tronicgr/AMC-AASD15A-Firmware/Syntron_HS_interface/README.md

Interface to Syntron HS servo

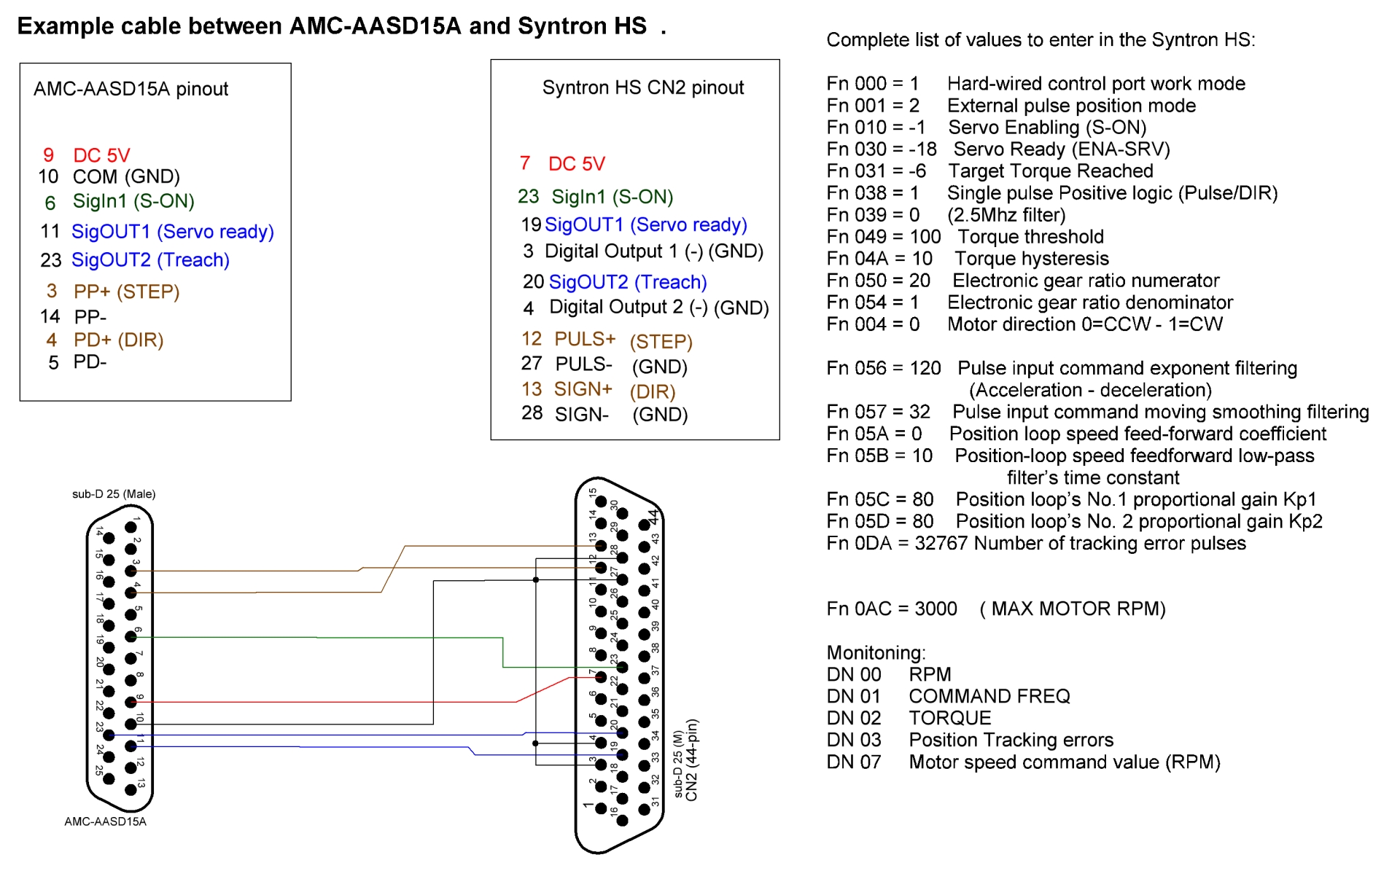
[picture p21: Syntron_HS_interface/AMC-AASD15A - Syntron HS connections schematic_sm.jpg]
