tronicgr/AMC-AASD15A-Firmware/Latest_firmware/MEGA2560_chip/README.md

Firmware files for AtMega2560 chip (256k).

-Firmware file link. (download the zip file and unpack it before using).

-AVRUBD utility to update the firmware, with settings for 2560 chip.

### Firmware Update procedure video
https://www.youtube.com/watch?v=F8kSDIicgcA

### INPORTANT notice:
- After loading new firmware, please hold down the "EXIT" button on the panel and press and release the "RESET" button on the controller to restore default parameters. See how its done on this video: https://www.youtube.com/watch?v=g12Grq-1LBQ

# Please use the AVRUBD utility in this folder to update the firmware on the controller.

-- enc_2560_SH_AMC_AASD15A_v2_26_fix9-3_RGB (2560 chipset only) (7/15/2025)
--------------------------------------------------
- Fixed platform naming, had some typos.
- Added backtrack for the defined vertical actuators, to correctly reposition when using the Simhub power saving option.
- Fixed calibration of horizontal actuators to be non blocking. Now repositions to 50% in the background.
- Belt tensioner can also power off with Simhub power saving option, as long is defined as vertical actuator type.
- FIXED LCD Menu rollover overflow
- 
-- ADDED platform presets:
- 1. RS-COMPETITION eracinglab platform 2xTL/Surge
- 2. eracinglab platform Belt/TL/SURGE
- 3. HEXAPOD - ROTARY (50:1, 140degrees)
- ADDED Parameters export dump, and quick manual F-Stop test sequence.

- Download shortcut: 
[enc_2560_SH_AMC_AASD15A_v2_26_fix9-3_RGB.zip](https://github.com/tronicgr/AMC-AASD15A-Firmware/blob/master/Latest_firmware/MEGA2560_chip/enc_2560_SH_AMC_AASD15A_v2_26_fix9-3_RGB.zip)
