tronicgr/AMC-AASD15A-Firmware/Thanos-utility/AMC-AASD_Config_tool/README.md

This is a remote configuration tool for the AMC-AASD15A controller boards.

It requires the firmware version v2.26 fix0 to function correctly. If you have older firmware it may not retrieve or save correctly all parameters.
