tronicgr/AMC-AASD15A-Firmware/Simtools_interface_plugin/README.md

Download and use this interface plugin for simtools
https://github.com/tronicgr/AMC-AASD15A-Firmware/blob/master/Simtools_interface_plugin/AMC_InterfacePlugin.zip

From the dropdown menu select "AASD15A"

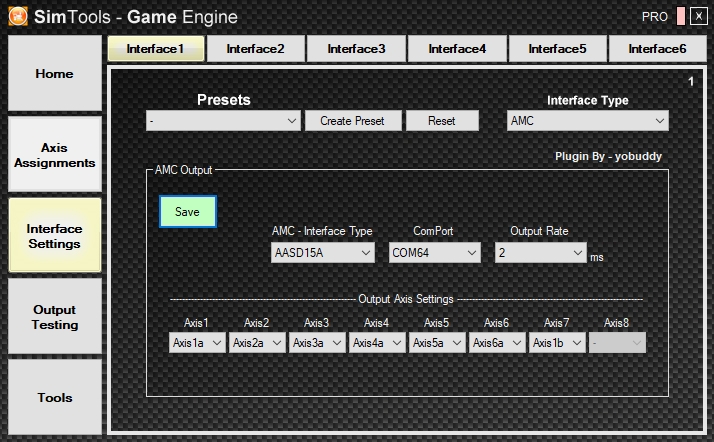
[picture p22: Simtools_interface_plugin/AMC_interface_plugin_AASD15A.jpg]


### You can use the AMC config tool v1.2 to access and modify the parameters in the AMC-AASD15A (Firmware v2.11 fix5):
https://github.com/tronicgr/AMC-AASD15A-Firmware/blob/master/Simtools_interface_plugin/AMC_Config_tool_1_2.zip

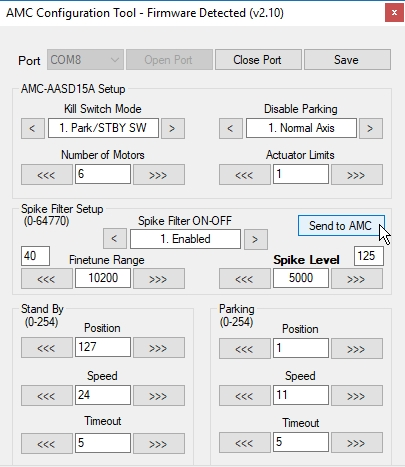
[picture p23: Simtools_interface_plugin/AMC-Config-tool-v1_2_AASD.jpg]
