tronicgr/AMC-AASD15A-Firmware/DornaM1_interface/AMC-AASD15A to Dorna EPS-B1 servomotor connections schematic.jpg

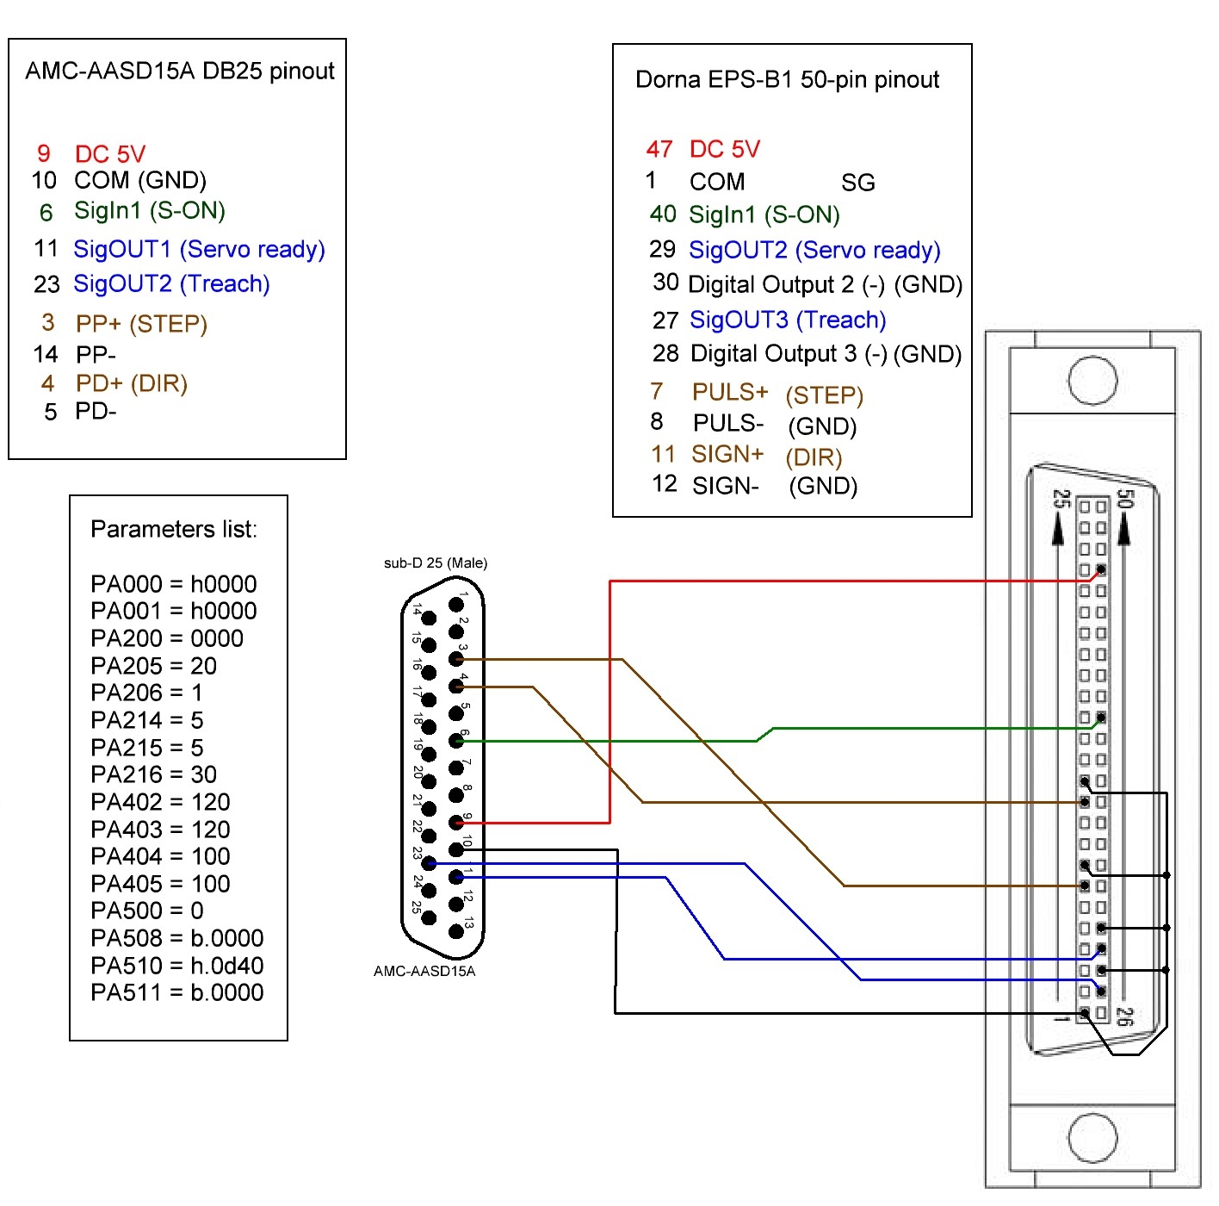
DornaM1_interface/AMC-AASD15A to Dorna EPS-B1 servomotor connections schematic.jpg
