tronicgr/AMC-AASD15A-Firmware/IMG_20190518_080840.jpg

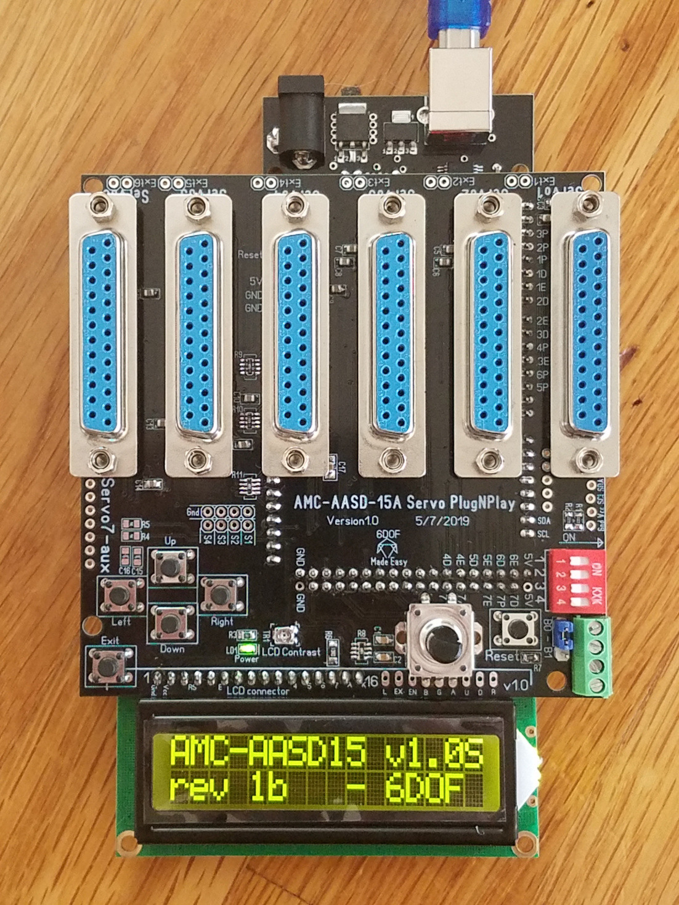
IMG_20190518_080840.jpg
