tronicgr/AMC-AASD15A-Firmware/Latest_firmware/1280_firm_LCD.jpg

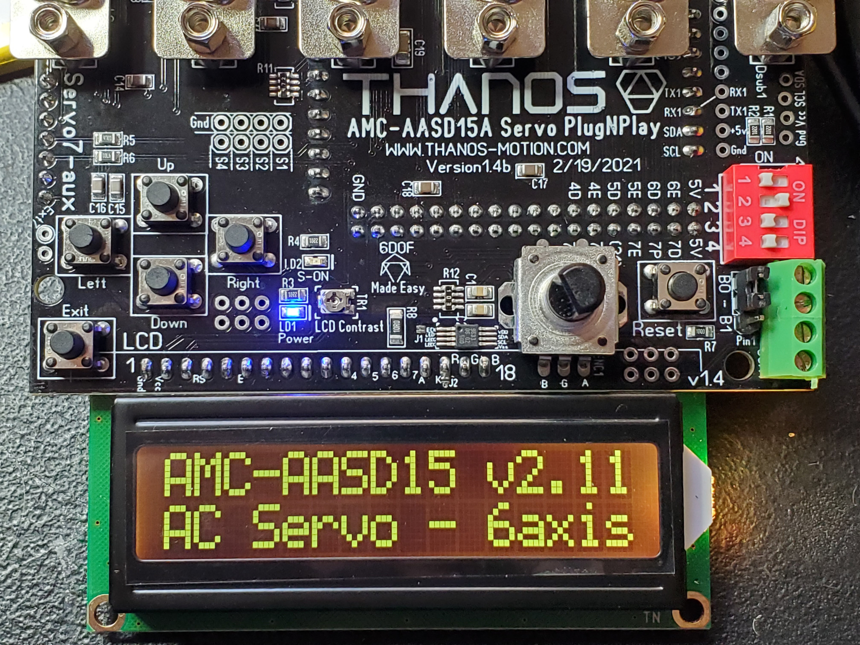
Latest_firmware/1280_firm_LCD.jpg
