tronicgr/AMC-AASD15A-Firmware/Simtools_interface_plugin/AMC-AASD15A_simtools interface plugin.jpg

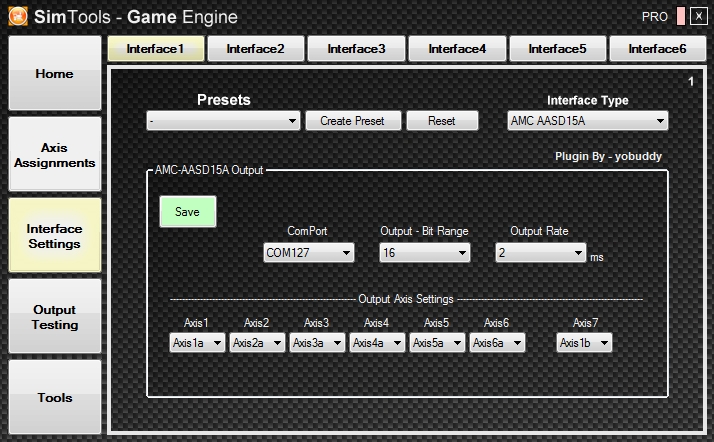
Simtools_interface_plugin/AMC-AASD15A_simtools interface plugin.jpg
