tronicgr/AMC-AASD15A-Firmware/Simtools_interface_plugin/AMC_config_AASD.jpg

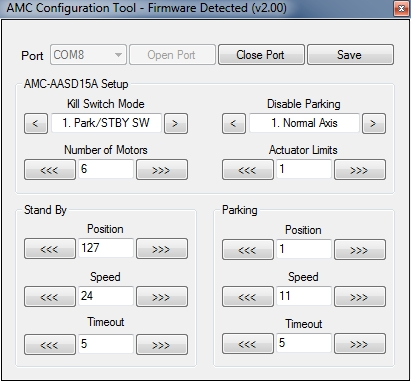
Simtools_interface_plugin/AMC_config_AASD.jpg
