tronicgr/AMC-AASD15A-Firmware/Manual-and-Datasheets/README.md

### See here manual and datasheets regarding the AMC-AASD15A servo controller

Latest manual:
https://github.com/tronicgr/AMC-AASD15A-Firmware/blob/master/Manual-and-Datasheets/User_Manual_v2_9-AMC-AASD15A_4DOF%2BTL%2BSurge-SRS-Simtools.pdf

### If transitioning from SFX100 software to use the AMC-AASD15A, please don't forget the extra parameters on the servo drives!!
