tronicgr/AMC-AASD15A-Firmware/AMC1280USB wiring for AASD-15A.jpg

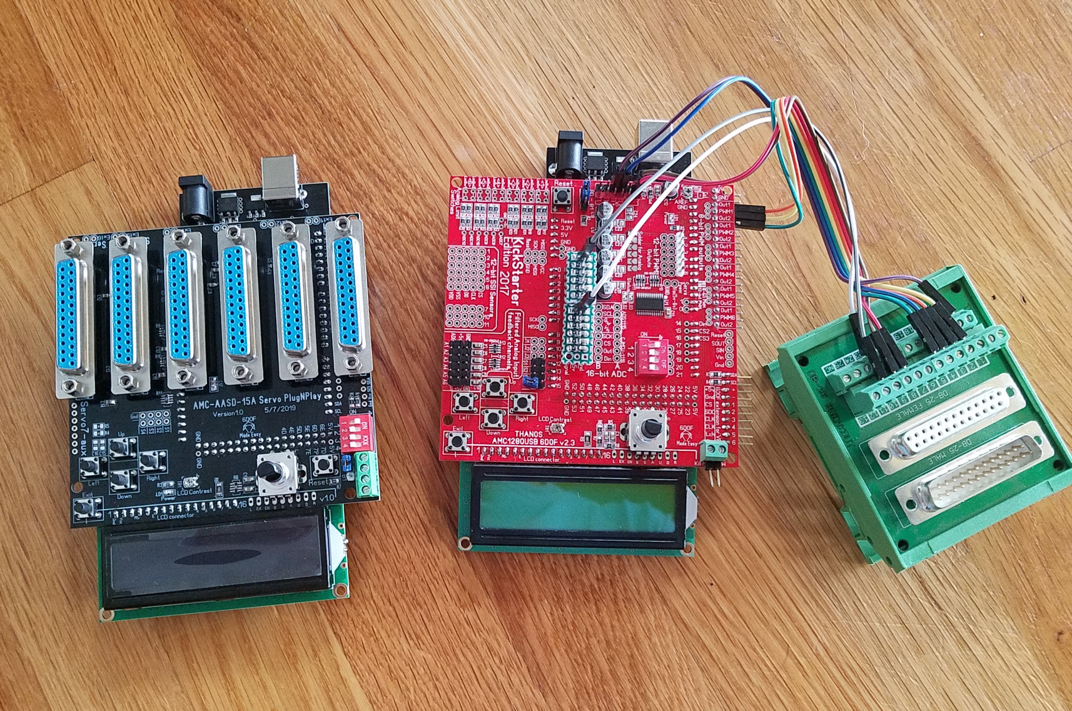
AMC1280USB wiring for AASD-15A.jpg
