tronicgr/AMC-AASD15A-Firmware/DornaM1_interface/Wiring AMC-AASD-15A to Dorna.GIF

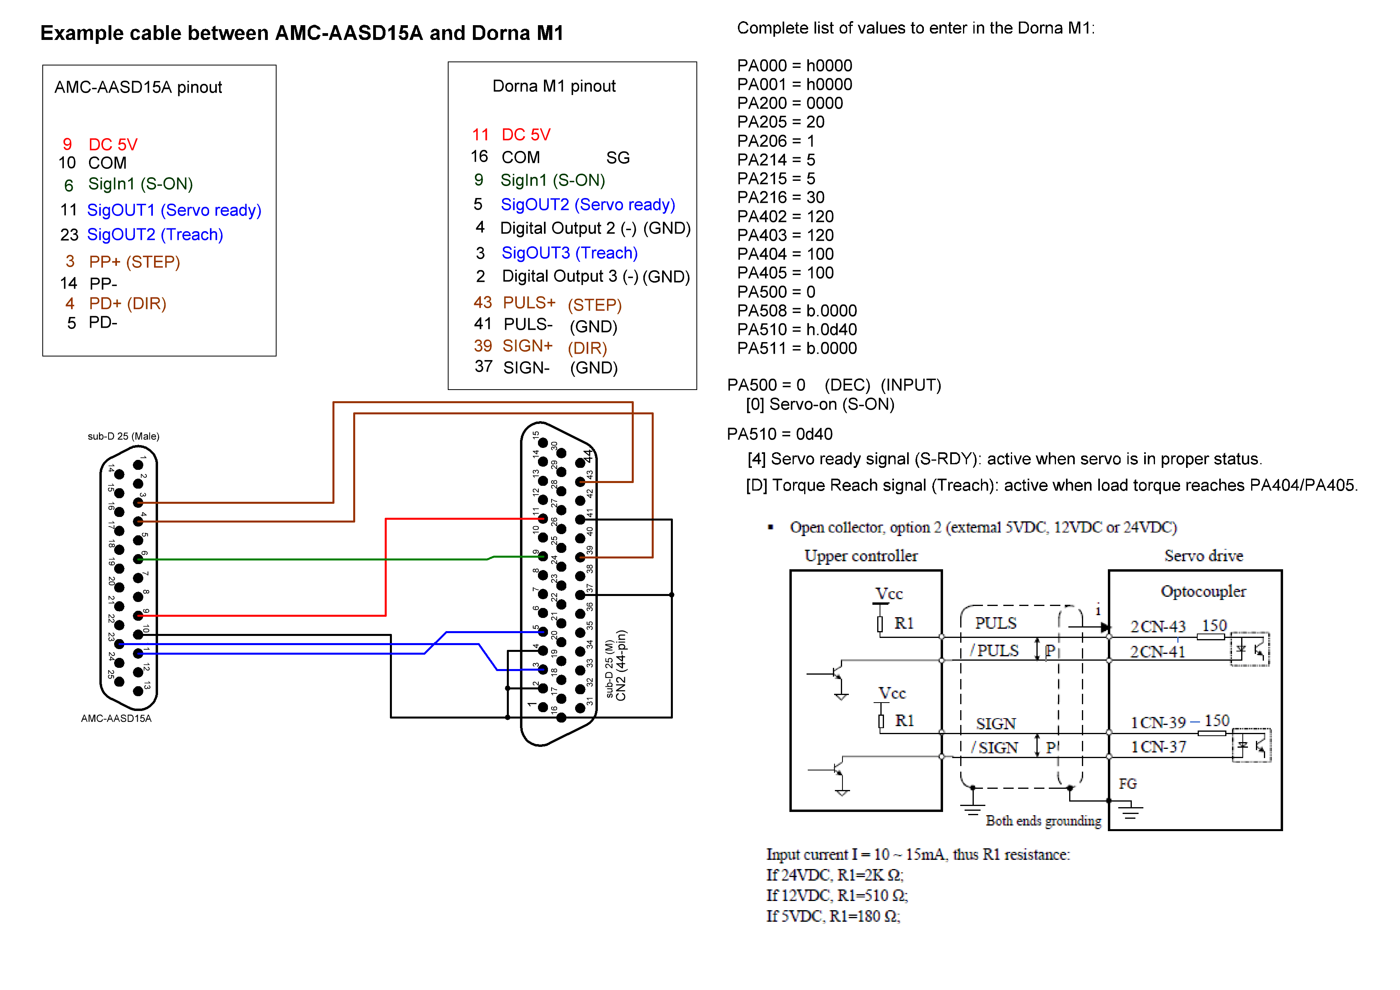
DornaM1_interface/Wiring AMC-AASD-15A to Dorna.GIF
