tronicgr/AMC-AASD15A-Firmware/Manual-and-Datasheets/AMC-AASD15A_to_servos_wiring_Diagram.jpg

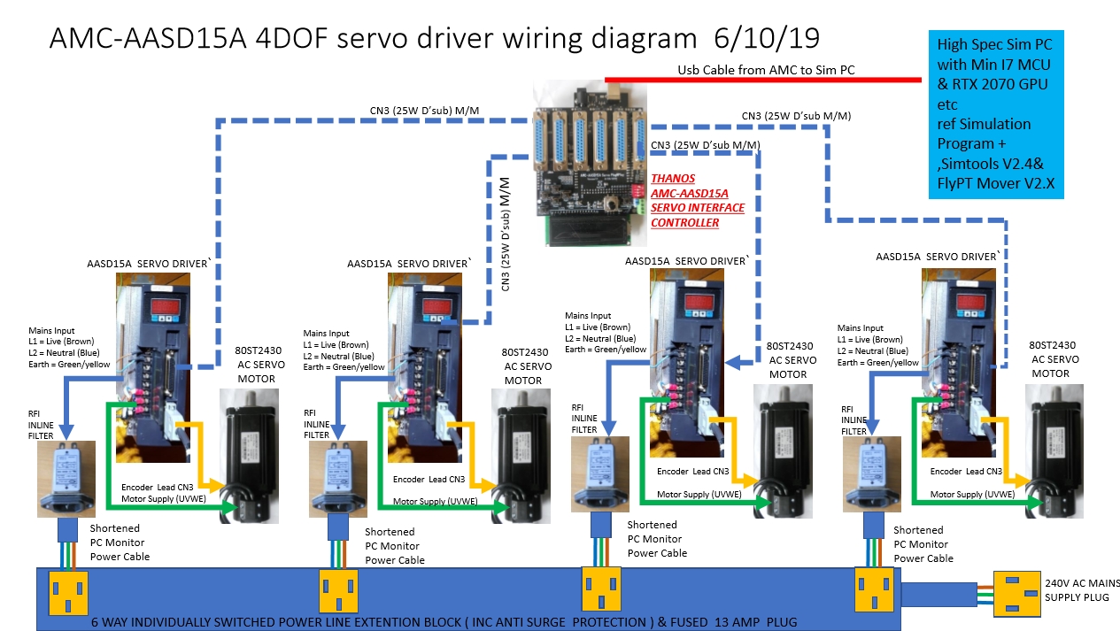
Manual-and-Datasheets/AMC-AASD15A_to_servos_wiring_Diagram.jpg
