tronicgr/AMC-AASD15A-Firmware/Manual-and-Datasheets/DB25 cable male-male wiring pinout AMC-Servo.gif

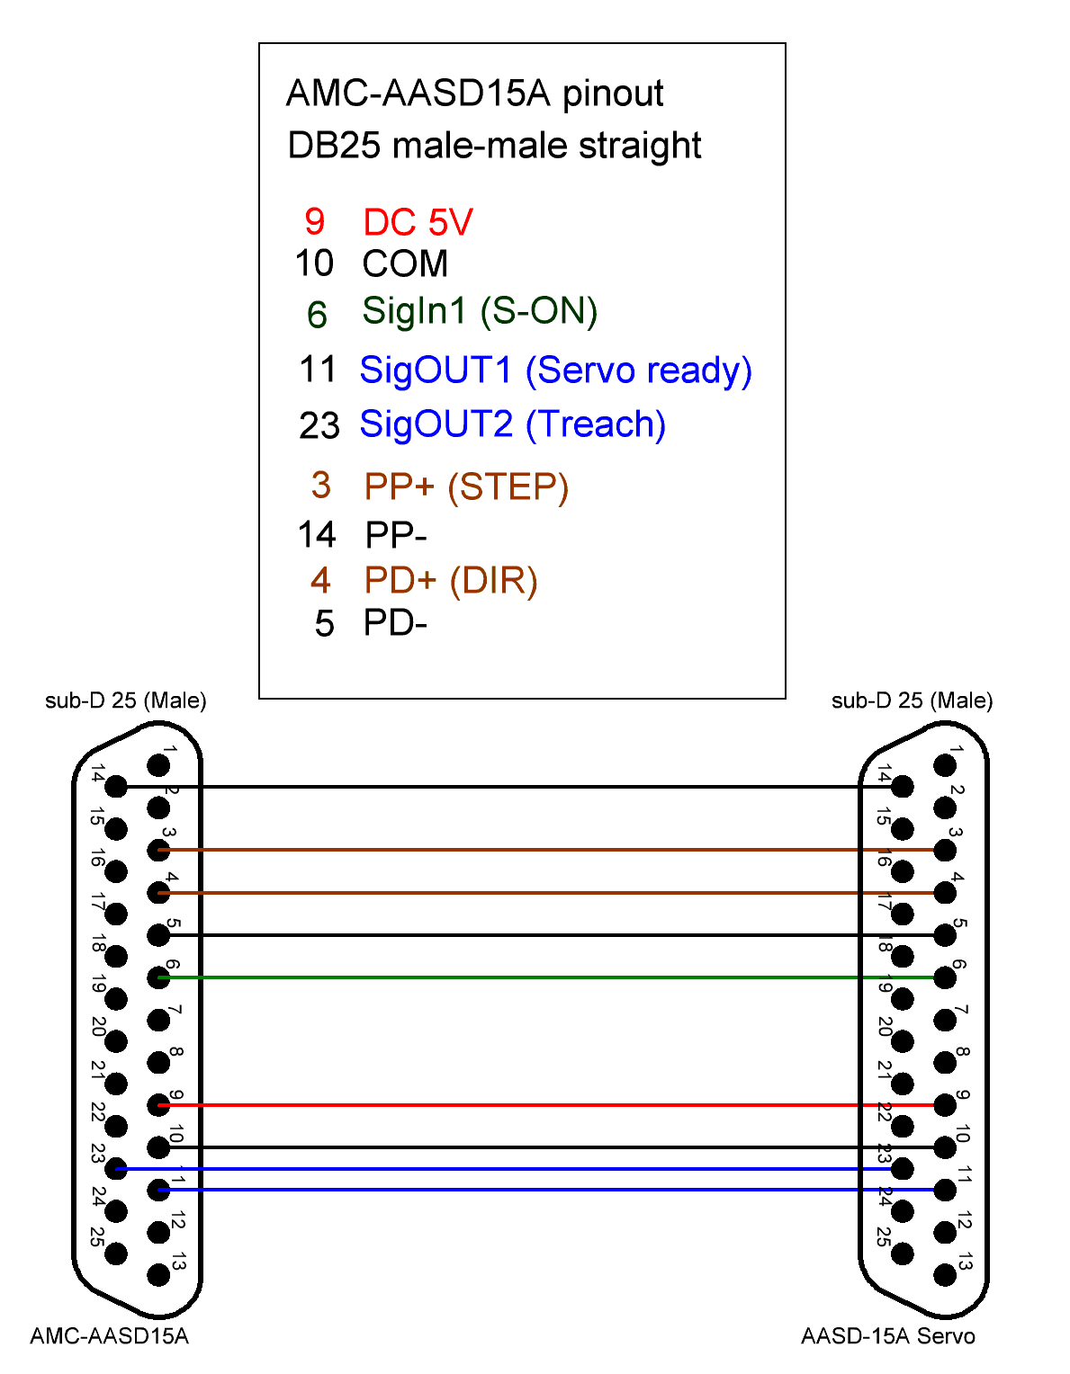
Manual-and-Datasheets/DB25 cable male-male wiring pinout AMC-Servo.gif
