tronicgr/AMC-AASD15A-Firmware/Thanos-utility/Thanos-motion-test-simple/README.md

This is a simple processing schetch with a single slider that will allow you to test the motion of the actuators using a slider.

The Thanos controller is automatically identified and the connection is enabled to it as soon the program runs. 
You may need to disconnect other USB devices from the computer, a message prompting you to do so may appear.

To Run it you will need to download Processing from here:
https://processing.org/

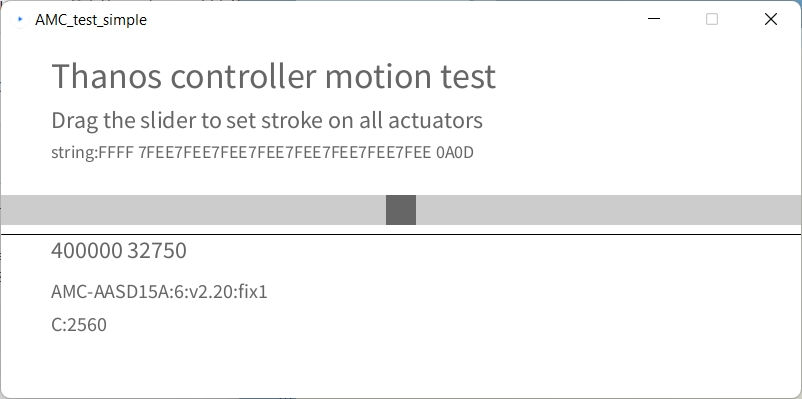
[picture p33: Thanos-utility/Thanos-motion-test-simple/Thanos_motion_test_simple.jpg]


.
.
.

- Updated version of the tool has sliders for all actuators now (amc_test_spike_on_off_all_sliders.pde):

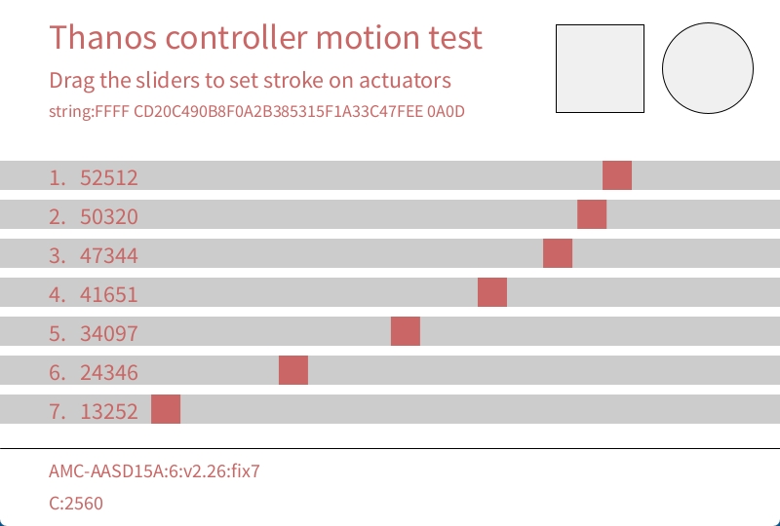
[picture p34: Thanos-utility/Thanos-motion-test-simple/all_sliders.jpg]


- Watch how this tool works on this video: https://www.youtube.com/watch?v=LwST1zbIPr8

### WARNING!!!
Modify on your own risk. Improper values or modification of functions, may end up on exceeding actuator speeds and damage your rig or injure youself.
