tronicgr/AMC-AASD15A-Firmware/Manual-and-Datasheets/USA_110v_receptacle_testing.jpg

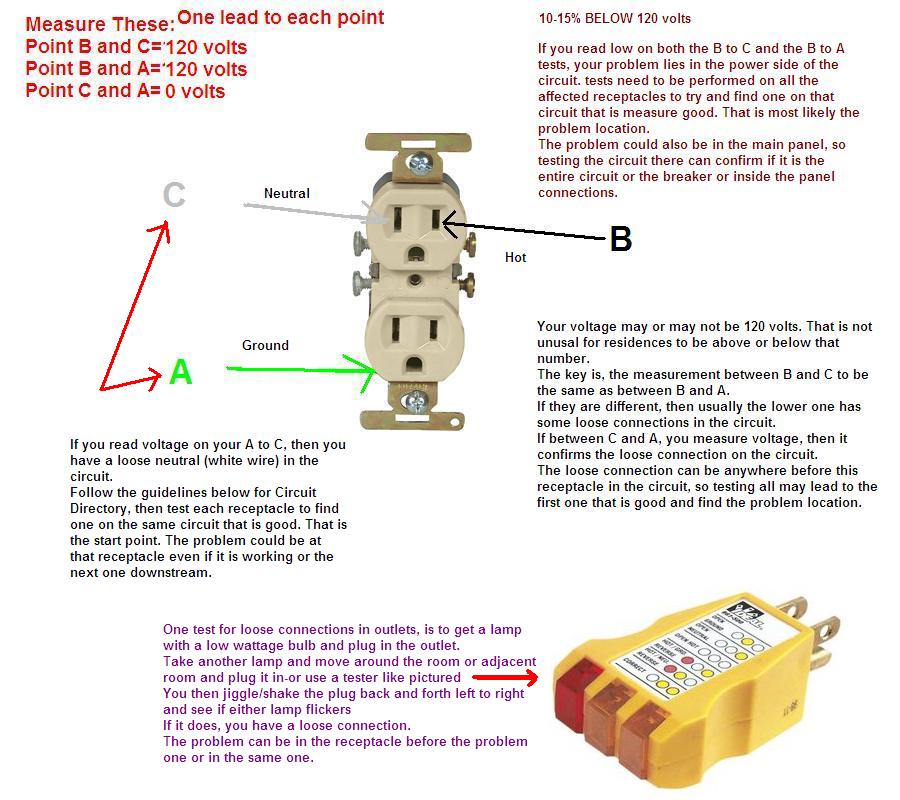
Manual-and-Datasheets/USA_110v_receptacle_testing.jpg
