tronicgr/AMC-AASD15A-Firmware/(threads)

Thread 2 (2020-01-23):

Blocking manual move of servos after calibration

tronicgr, 2020-01-23:
This causes one by one movement of actuators to the park position that is more visible if the park position is not at 0%.

This was coded to avoid having the motor "jump" to position if re-calibration occurs while in online data mode.

Need to add definition of the axis position to match the initial 0 position of the servo, and force the system offline to let it track slowly the online data positions.

tronicgr, 2020-01-27:
The motor now calibrate and position themselves in the background without blocking motion of other actuators

https://github.com/tronicgr/AMC-AASD15A-Firmware/blob/master/Beta_Firmware/enc_6dof_AMC_AASD15A_v2_09_fix_cal1.zip

Waiting feedback.

tronicgr, 2020-01-27:
Seems it works correctly!!

https://youtu.be/DgnY1wm1C0Y

I will be closing the issue sooner than I thought  👍

tronicgr, 2020-01-30:
There was a report of e-stop mode was not saved correctly and was reverting after reset. It was fixed in this version.

https://github.com/tronicgr/AMC-AASD15A-Firmware/blob/master/Beta_Firmware/enc_6dof_AMC_AASD15A_v2_09_fix_cal2.zip

tronicgr, 2020-02-09:
Need to reduce the speed of the motor while this backtrack motion happens, when the leadscrew type is larger than 1605. It makes larger backtrack motion that can translate to several more mm distance that is clearly visible and unsynchronized.

[https://youtu.be/TS7j7NqBCkA](https://youtu.be/TS7j7NqBCkA)

tronicgr, 2020-02-09:
Also fix the indication LEDs state when recovering from e-stop to normal online state:

https://youtu.be/5k8k3OA3Ilc

tronicgr, 2020-02-25:
All the above were fixed on the enc_6dof_AMC_AASD15A_v2_09_fix_filter4.

closing this

Closed 2020-02-25.

Thread 3 (2020-01-23):

Add filtering for spikes from the motion software

tronicgr, 2020-01-23:
Some adjustments need to be done on the AASD-15A servo parameters to adjust the S-curve for softer accelerations and decelerations, as well add some basic spike filtering in the firmware of the AMC-AASD15A to avoid having the motor execute glitches in the motion software or game motion cues.

This will be pre-filter between the serial data receiver and the processor for the motion data. Most likely a median calculation method with one or two iterations latency.

This filter will be especially useful for large load platforms that need to be spike free to stress less the motors and mechanical parts.

tronicgr, 2020-01-27:
I'll be adding moving average filter that is light and fast. See early tests here:

https://youtu.be/mTudXUTFtGk

tronicgr, 2020-02-19:
This was addressed by enc_6dof_AMC_AASD15A_v2_09_fix_filter3.zip

Closed 2020-02-19.

Thread 4 (2020-02-03):

Firmware changes for SafetyBox usage with AASD15A

aj-whirlybird, 2020-02-03:
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

1) Alive signal: Frequency signal that changes its state regularly. The SafetyBox uses this signal to detect if the AMC controller is alive.
- implemented in V2.07 quick fix, see:
https://github.com/tronicgr/AMC-AASD15A-Firmware/blob/master/Beta_Firmware/enc_6dof_AMC_AASD15A_v2_07_quick_fix.zip
- if possible with a pulse time of about 2ms. This frequency should not vary too much with the number of axes, i.e. the state should change after each axis calculation. Thus there are more pulses the more axes are plugged in. Overall, however, the frequency remains about the same, since each axis calculation requires time.
- output on free S3 port, like quick fix.

2) S1: E-Stop/Park/Standby input: In future this signal will be controlled by the SafetyBox. Since it can trigger three states: E-Stop, Standby and Park it is not easy to control. This signal toggles between Park and Standby each time it is pressed. The first status is random and depends on the previous E-stop cycles.
It would be simpler for the control if the first press of the button always led to standby, i.e. when it is released, standby is always preceded.

3) 2nd E-stop channel: With this signal the control of the drives is extended by a second E-stop channel, which is directly controlled by the SafetyBox.
This function uses SigIn2 on AASD15A drive.
Parameter change: Pn053 = 7 (EMG).
- 2nd E-stop channel: This is the biggest change!
- Signal: on 25p D-Sub pin 7
- Hardware: all pin 7 have to connect together
- Firmware: I hope there's nothing to do.
- Test: when an E-stop occurs, the SafetyBox sets the S1 input on the AMC controller to LOW and also the pin 7 at every D-Sub connector. This should work without firmware changes

Thread 5 (2020-02-25):

Add parameter in menu to setting calibration speed

tronicgr, 2020-02-25:
This is needed to rectify slow calibration on large ratio gearboxes, or too fast and abrupt calibration on large 2525 leadscrew actuators.

Thread 6 (2021-09-23):

RC Servo PWM or PPM

vfear, 2021-09-23:
Hi, I want to control RC servo motors directly from your board.  Is it possible?  is there a choice of RC Servo mode in the settings?

Thread 7 (2024-07-06):

Fix 8 backtrack merge values issue

beaustpierre, 2024-07-06:
Hexapod setup; 6 actuators - After updating to fix 8 I have noticed that after setting actuator 1s backtrack value and then selecting merge values does not merge the values with any of the other actuators.

Setting them individually is successful.

Attempts to merge after individual saving is still unsuccessful.
