tronicgr/AMC-AASD15A-Firmware/(list of files, drawings)

Other design files:
DornaM1_interface/AMC-AASD15A to Dorna servomotor connections schematic.spl7
