tronicgr/AMC-AASD15A-Firmware/(commit log)

2019-05-26 Fixed proper trigger for servo code activation
2019-05-30 Updated a schematic
2019-09-13 Fixed missing schematic in manual
2019-10-29 AASD-15A servo drive manual
2020-01-27 parallel move to standby after calibration
    The motor now calibrate and position themselves in the background without blocking motion of other actuators
2020-02-05 Beta test for filtering
    Applies filter to all axis, adjustable by Filter Factor under Pulse Freq parameter submenu.
2020-02-18 Fixed jump during calibration of motors
    The filter can be set to run globally, even on offline mode.
    The motors must be parked or powered off as there is safety that does not allow modification of the filter factor value otherwise, like when you operate the buttons on the panel, or being on online mode.
2020-02-28 decreased max value of spike filter to 32767
2020-02-28 Decreased Spike Filter max level to 8000
2020-03-03 Added info for Smoothing and Spike filters
2020-03-10 Spike filter enables Yellow led now.
2020-04-10 Fixed ON-OFF jump and proper Online switch
2020-04-21 Fixed jump issue when using Force Offline Switch
2020-08-28 RGB LCD support and menu fixes
    Support for the new RGB LCD colored screens and modifications in the user menu system to selecting actuators using left-right buttons.
2020-12-03 Spike Filter Fixes
    separated standby speed from spike filter entirely, to park and start online motion slowly. Also added adjustable ESC speed during spike filter events.
2022-01-08 Add files via upload
    Shifted servo ports 1->3 , 2->4 , 3->5 , 4->6 for SRS 3DOF (OLD AMC1280USB)
2022-06-20 Add files via upload
    Added EXIT+DOWN for forced Home calibration
2022-08-28 Belt Tensioner trim test
2022-08-29 Belt Tensioner test2
2023-01-26 Add files via upload
    slider test with Spike Filter control
2025-05-25 Add files via upload
    ' FIXED LCD Menu rollover overflow
    --- ADDED platform presets:
    - 1. eracinglab platform 2xTL/Surge
    - 2. eracinglab platform Belt/TL/SURGE
    - 3. HEXAPOD - ROTARY (50:1, 140degrees)
    ' ADDED Parameters export dump, and quick manual F-Stop test sequence.
